StefansCode/BachelorThesisCS/README.md

This is my bachelor thesis in computer science.
