StefansCode/BachelorThesisCS/latex/tex/1_0_hardware.tex

\section{Die Hardware}

Das Ziel bei der Hardwarewahl ist es möglichst günstige und weit
verbreitete Komponenten zu wählen. So kann der Synthesizer
leicht nachgebaut werden.

\subsection{ESP32-S3}

\begin{figure}[h]
    \begin{center}
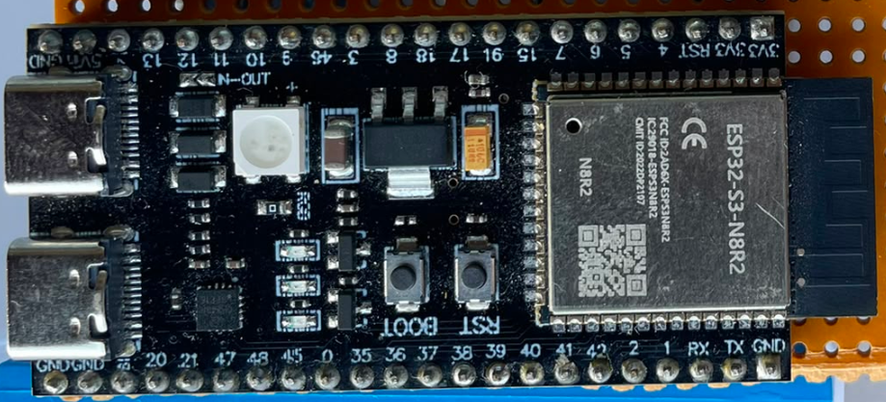
[picture p1: latex/fig/components/ESP32S3.png]
        
        \caption{ESP32-S3 Entwicklungsboard.}%
        \label{fig:ESP32S3}
    \end{center}
\end{figure}

% Neben Arduino-boards \cite{arduino} sind ESP32-boards von Espressif Systems
% \cite{espressif} die bekanntesten
% Mikrocontrollerboards. Außerdem sind sie für unter 10 € günstig erhältlich.

Die zentrale Recheneinheit des Synthesizers ist ein ESP-S3 von 
Espressif Systems.
Ein ESP32-S3 ist ein Mikrocontroller mit einer 
32-Bit-Dual-Core-CPU, die mit 240MHz betrieben werden kann\cite[4.1.1.1]{espDatashet}.
Bei einer Abtastrate von 44100 lässt sich theoretisch jeder Wert 
mit ca. 
$240MHz / 44100Hz = 5442$ Taktzyklen bearbeiten. Das lässt genug Zeit für 
verschiedene DSV-Operationen.

% Der ESP32-S3 wurde anderen ESP32 Microcontrollern vorgezogen, da er
% spezielle Hardware besitzt, um DSP-Operationen zu beschleunigen. Zum 
% Beispiel hat er spezielle Instruktionen für 128-Bit-Operationen
% \cite[4.1.1.2]{espDatashet}.

Ein weiterer Vorteil des ESP32-S3 ist, dass er viele GPIO-Pins und 
Peripherieschnittstellen hat.
Wichtig für dieses
Projekt sind vor allem GPIO-Pins für Taster und einen Encoder, I2C für 
einen OLED-Bildschirm und I2S für die Ausgabe der Audio-Signale.

\subsection{MAX98357A-I2S-DAC}

\begin{figure}[h]
    \begin{subfigure}{0.48\textwidth}
    \begin{center}
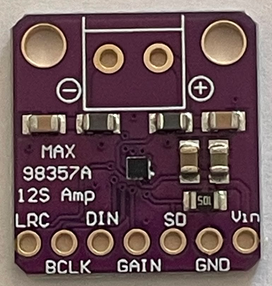
[picture p2: latex/fig/components/dac_front.png]
        
    \end{center}
    \end{subfigure}
    \hfill
    \begin{subfigure}{0.48\textwidth}
    \begin{center}
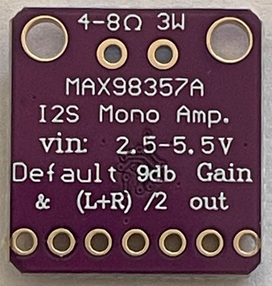
[picture p3: latex/fig/components/dac_back.png]
        
    \end{center}
    \end{subfigure}
\caption{MAX98357A-I2S-DAC}
\label{fig:DAC}
\end{figure}

Ein MAX98357A-DAC (Digital-zu-Analog Converter) \cite{MAX983572026Datasheet} 
ist ein Verstärker, der einen Digital-zu-Analog Converter (DAC) enthält.
Dieser wandelt das digitale Signal in analoges Signal um und verstärkt es so, dass es
direkt an einen passenden Lautsprecher weitergeleitet werden kann.
Dadurch kann während der Entwicklung auf einen externen Verstärker verzichtet werden.

Der MAX98357A kann Abtastraten von 8kHz, 16kHz, 32kHz, 44.1kHz,
48kHz, 88.2kHz oder 96kHz und eine Auflösung von 
16, 24 oder 32 Bit
verarbeiten \cite{MAX983572026Datasheet}[Digital Audio Interface Modes].

Das analoge Signal wird von dem DAC zu einer 3,5mm-Klinkenbuchse geleitet. 
So kann leicht ein Lautsprecher angeschlossen werden. 
% Klinkenstecher sind 
% unterteilt in mehrere segmente und haben in der Regel die Masseverbindung 
% an dem ring, der am nächsten am kabel ist. Deshalb wird der vorderste Pin 
% der Buchse mit dem negativen Ausgang des DACs verbunden. Da der MAX98357A 
% ein Monosignal (nur ein Signal und nicht rechts und links) sendet, werden 
% die beiden anderen Pins der Buchse mit dem Positiven Ausgang verbunden.

\begin{figure}[h]
    \begin{subfigure}{0.48\textwidth}
    \begin{center}
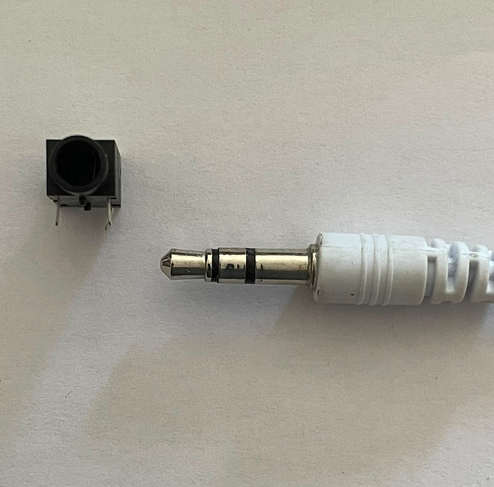
[picture p4: latex/fig/components/aux_front.png]
        
    \end{center}
    \end{subfigure}
    \hfill
    \begin{subfigure}{0.48\textwidth}
    \begin{center}
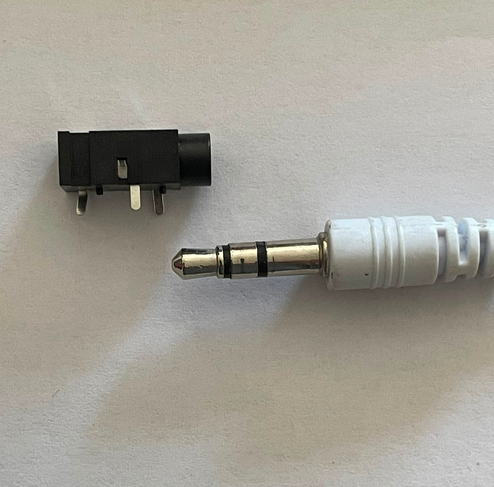
[picture p5: latex/fig/components/aux_side.png]
        
    \end{center}
    \end{subfigure}
\caption{Klinkenbuchse und Stecker}
\label{fig:AUX}
\end{figure}

\subsection{Nutzereingabe}

Als Nutzereingabe werden Taster und ein Drehgeber verwendet.

\begin{figure}[h]
    \begin{subfigure}{0.48\textwidth}
    \begin{center}
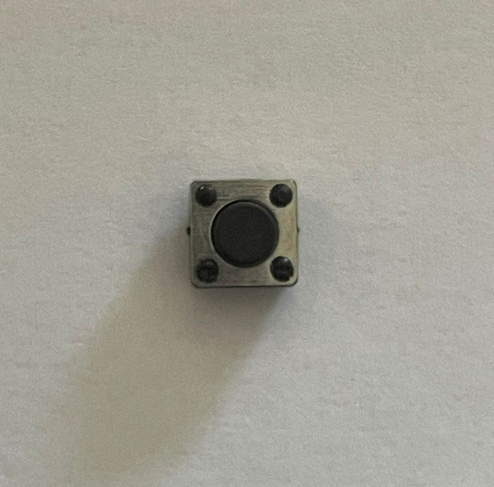
[picture p6: latex/fig/components/button_top.png]
        
    \end{center}
    \end{subfigure}
    \hfill
    \begin{subfigure}{0.48\textwidth}
    \begin{center}
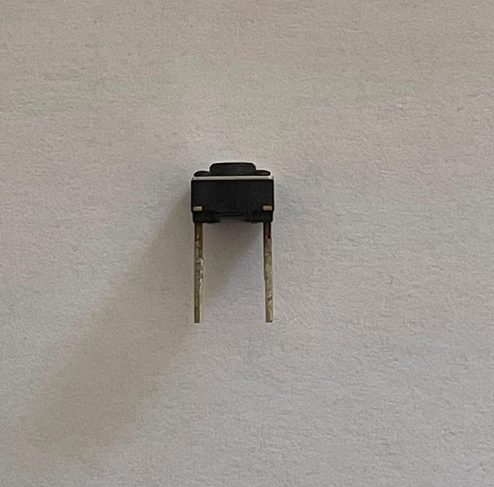
[picture p7: latex/fig/components/button_side.png]
        
    \end{center}
    \end{subfigure}
\caption{Einfacher Taster}
\label{fig:Taster}
\end{figure}

Ein Taster kann als einfacher Eingabeknopf genutzt werden. Er wird zwischen die Masse
und einen GPIO-Pin geschaltet und setzt diesen Pin beim Drücken auf LOW.

\begin{figure}[h]
    \begin{subfigure}{0.48\textwidth}
    \begin{center}
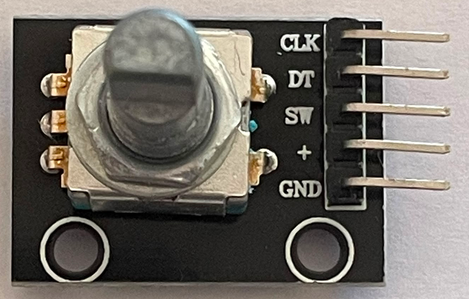
[picture p8: latex/fig/components/encoder_top.png]
        
    \end{center}
    \end{subfigure}
    \hfill
    \begin{subfigure}{0.48\textwidth}
    \begin{center}
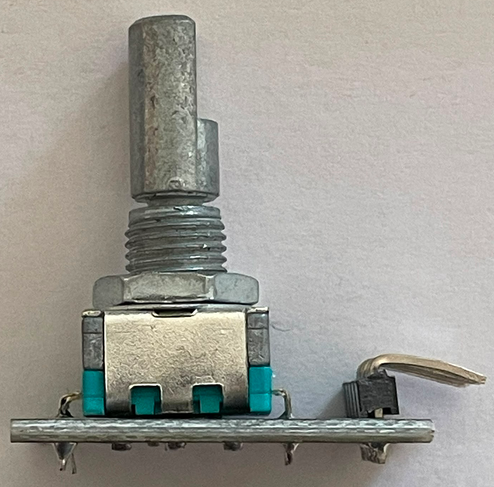
[picture p9: latex/fig/components/encoder_side.png]
        
    \end{center}
    \end{subfigure}
\caption{Drehgeber}
\label{fig:Drehgeber}
\end{figure}

Ein inkrementeller Drehgeber (englisch: encoder) kann mithilfe von zwei phasenverschobenen Signalen, die
an den Pins DT und CLK anliegen, angeben, in welche
Richtung er gedreht wird \cite{tiSBOA200}. Diese Drehung ist unbegrenzt, erfolgt aber
nur in Schritten. Die Pins müssen mit GPIO-Pins des ESP32-S3 
verbunden werden.

Mit 10 Tastern und einem Drehgeber ist es möglich,
während der Laufzeit verschiedene Variablen zu bearbeiten.
Die genaue Funktion dieser Komponenten wird in Kapitel \ref{chap:synth} beschrieben.

\subsection{OLED-Bildschirm}

\begin{figure}[h]
    \begin{subfigure}{0.48\textwidth}
    \begin{center}
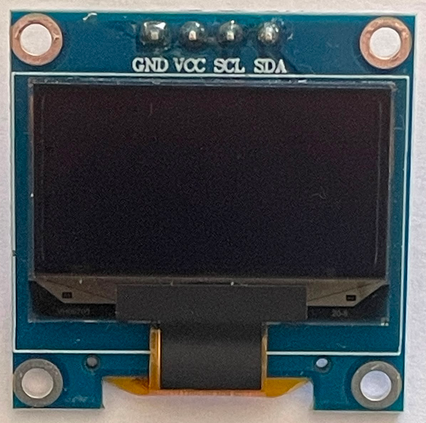
[picture p10: latex/fig/components/screen_front.png]
        
    \end{center}
    \end{subfigure}
    \hfill
    \begin{subfigure}{0.48\textwidth}
    \begin{center}
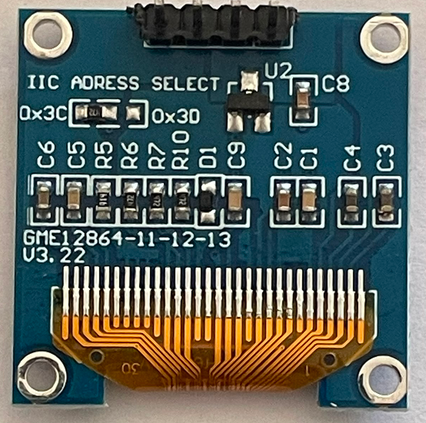
[picture p11: latex/fig/components/screen_back.png]
        
    \end{center}
    \end{subfigure}
\caption{OLED-Bildschirm}
\label{fig:OLED-Bildschirm}
\end{figure}

Ein SSD1306 OLED-Bildschirm mit einer Auflösung von 128x64 Pixeln wird genutzt, 
um dem Nutzer anzuzeigen, welche
Variable geändert wird. Die Verbindung zum ESP32 passiert über das
I2C-Protokoll.

\subsection{Pinbelegung und Löten}

Nun müssen alle Komponenten mit dem ESP32-S3 verbunden werden.
Der ESP32-S3 hat intern eine GPIO-Matrix, welche es ermöglicht fast
jeden internen Peripheriecontroller mit fast jedem Pin zu verbinden 
\cite{esp32S3gpio}.

Zusätzlich zu den oben aufgezählten Komponenten wurden ein SD-Karten-Anschluss
über die SPI-Schnittstelle als mögliche Erweiterung verbunden. 
Dieser wurde in dieser Arbeit allerdings nicht genutzt.

Die Wahl der Pins ist für I2S, I2C und GPIO fast immer frei wählbar.
Es ist zwar möglich die folgenden Ausnahmen zu benutzen, aber nicht empfohlen.
\begin{itemize}
    \item Pins 19 und 20 sind mit dem JTAG-Debugger verbunden.
    \item Pins 44 und 48 sind mit den eingebauten LEDs verbunden.
    \item Pins 0, 3, 45 und 46 sind Strappingpins. Das sind Pins, die das Bootverhalten
            ändern können, je nachdem, ob an ihnen während des Bootvorgangs ein
            High- oder Low-Pegel anliegt.
    \item Pins 33--37 sind mit dem SPI-Flash und dem PSRAM auf dem
    Entwicklungsboard verbunden.
\end{itemize}

Mit diesen Einschränkungen wurde die Pinbelegung aus Anhang \ref{sec:pinout} 
gewählt.
Anschließend wurde alles auf eine Lochplatine gelötet. 
Diese ist in Abbildung \ref{fig:platine} zu sehen.

\subsection{Design und Drucken eines Gehäuses}

Als Abschluss der Hardware wurde das Gehäuse aus Abbildung \ref{fig:hülle_außen} 
3D-gedruckt. Dieses
ist natürlich hauptsächlich für die Optik, es sorgt aber auch für ein 
besseres Handgefühl und schützt die Platine vor Beschädigungen.

Zum Erstellen des 3D-Objektes wurde Fusion360\cite{fusion360} verwendet.
In Fusion360 ist es möglich ein Bild als Referenz zu laden. 
Das hat sich als schneller und genauer herausgestellt, als die Maße von der 
Platine zu nehmen.

% In Fusion360 wird das erstellte 3D-Objekt als stl-Datei exportiert und dann
% in dem Bambu Lab Studio Slicer \cite{bambulabStudio} zu einer gcode-Datei konvertiert.
% Eine gcode-Datei enthält die Anweisungen für den 3D-Drucker und in einem 
% Slicer kann man Parameter wie die Schichthöhe, die Druckgeschwindigkeit, 
% die Temperatur der Düse und der Heizplatte, die Fülldichte von 
% Holräumen, etc. einstellen. Außerdem werden Stützen für Überhänge erstellt,
% da der Drucker nicht in der Luft drucken kann und man kann sehen wieviel 
% Material verbraucht wird und wie lange der Druck braucht.
% Der gcode wird dann an den 3D-Drucker Bambu Lab P1S \cite{bambulabP1S}
% geschickt, der das Gehäuse Schicht für Schicht druckt.

% Zunächst wurde ein dünner Prototyp der Vorderseite gedruckt, da diese die 
% meisten Öffnungen hat. Nach ein paar kleinen Anpassungen wurden die 
% Seitenwände mit einer kleinen Einkerbung am Ende erstellt. Nach Maßen
% wurden Löcher für die USB-, Aux- und SD-Karten-Anschlüsse hinzugefügt.

% Es wurden 10 Knöpfe für die Taster gedruckt. Die Aufschriften der Knöpfe sind 
% A, B, 1, 2, 3, 4, 5, 6, 7 und 8. Deren Funktionen werden in Kapitel \ref{chap:synth} beschrieben.

% In die Löcher für die Taster kommen kleine Knöpfe, die genau in die 
% Löcher passen, aber unten etwas breiter sind damit sie nicht hinausfallen.
% Für den Boot- und Resetknopf auf dem ESP32-S3 gibt es Auch jeweils einen Knopf.
% Die sind allerdings kleiner. 

% Die Platine wird durch 2 Säulen und 4 kleine Blöcke in dem Gehäuse gehalten. 
% In die Spitze der Säulen wurden Einschmelzgewinde eingeschmolzen, 
% um die Rückwand des Gehäuses mit Schrauben zu befestigen.

Zum Drucken wurde der 3D-Drucker Bambu Lab P1S \cite{bambulabP1S} verwendet.
Auf der Githubseite zu dieser Arbeit sind die STL-Datei und eine STEP-Datei
des Gehäuses zu finden\cite{meinGithub}.
