StefansCode/BachelorThesisCS/latex/appendix.tex

\section{Pinbelegung}
\label{sec:pinout}
\begin{table}[H]
    \centering
    \begin{tabular}{c|l|l|l}
        \textbf{Pin} & \textbf{Typ} & \textbf{Funktion} & \textbf{Bemerkung} \\
        \hline
        0  & --        & --              & Strapping-Pin, nicht empfohlen \\
        1  & PCNT      & Encoder DT      & \\
        2  & PCNT      & Encoder CLK     & \\
        3  & --        & --              & Strapping-Pin, nicht empfohlen \\
        4  & GPIO IN   & BTN\_11         & \\
        5  & GPIO IN   & BTN\_12         & \\
        6  & GPIO IN   & BTN\_13         & \\
        7  & GPIO IN   & BTN\_14         & \\
        8  & GPIO IN   & Encoder\_SW     & \\
        9  & GPIO IN   & BTN\_21         & \\
        10 & GPIO IN   & BTN\_22         & \\
        11 & GPIO IN   & BTN\_23         & \\
        12 & GPIO IN   & BTN\_24         & \\
        13 & GPIO IN   & BTN\_B          & \\
        14 & GPIO IN   & BTN\_A          & \\
        15 & --        & --              & \\
        16 & I\textsuperscript{2}S & I\textsuperscript{2}S DIN & DAC \\
        17 & I\textsuperscript{2}S & I\textsuperscript{2}S BCK & DAC \\
        18 & I\textsuperscript{2}S & I\textsuperscript{2}S LRC & DAC \\
        19 & USB-JTAG  & USB-JTAG        & standardmäßig USB D- \\
        20 & USB-JTAG  & USB-JTAG        & standardmäßig USB D+ \\
        21 & --        & --              & \\
        \hline
        22--34 & --     & nicht vorhanden & \\
        \hline
        35--37 & --     & Flash/PSRAM     & abhängig von Flash/PSRAM-Konfiguration \\
        38 & SPI       & SPI CS          & SD-Karte \\
        39 & SPI       & SPI MOSI        & SD-Karte\\
        40 & SPI       & SPI CLK         & SD-Karte\\
        41 & SPI       & SPI MISO        & SD-Karte\\
        42 & I\textsuperscript{2}C & I\textsuperscript{2}C SCL\\
        43 & --        & --              & U0TXD / UART0 \\
        44 & GPIO      & BUILTIN\_LED    & U0RXD / UART0 \\
        45 & --        & --              & Strapping-Pin, nicht empfohlen \\
        46 & --        & --              & Strapping-Pin, nicht empfohlen \\
        47 & I\textsuperscript{2}C & I\textsuperscript{2}C SDA & \\
        48 & RMT       & BUILTIN\_RGB\_LED & Fehleranzeige \\
    \end{tabular}
    \caption{Pinbelegung des ESP32-S3.}
    \label{tab:pinout}
\end{table}

\section{Bilder zur Entwicklung der Hülle}

\begin{figure}[h]
    \begin{subfigure}{0.48\textwidth}
    \begin{center}
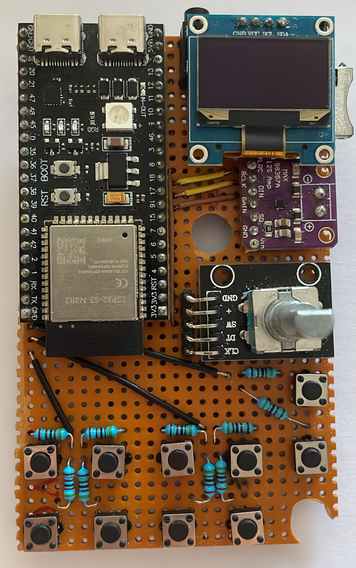
[picture p12: latex/fig/case/platine_front.png]
        
    \end{center}
    \end{subfigure}
    \hfill
    \begin{subfigure}{0.48\textwidth}
    \begin{center}
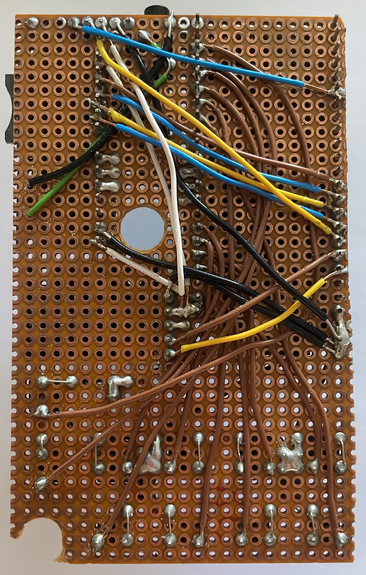
[picture p13: latex/fig/case/platine_back.png]
        
    \end{center}
    \end{subfigure}
\caption{Lochplatine mit angelöteten Komponenten}
\label{fig:platine}
\end{figure}

\begin{figure}[H]
    \begin{subfigure}{0.48\textwidth}
    \begin{center}
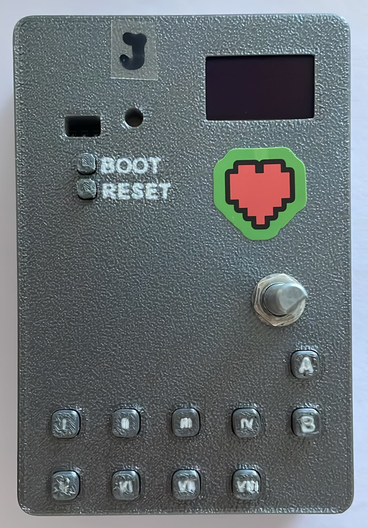
[picture p14: latex/fig/case/assembled_front.png]
        
    \end{center}
    \end{subfigure}
    \hfill
    \begin{subfigure}{0.48\textwidth}
    \begin{center}
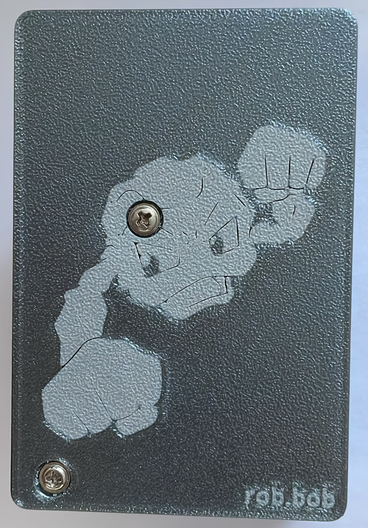
[picture p15: latex/fig/case/assembled_back.png]
        
    \end{center}
    \end{subfigure}
\caption{Ein Gehäuse für die Platine}
\label{fig:hülle_außen}
\end{figure}

\begin{figure}[H]
    \begin{subfigure}{0.48\textwidth}
    \begin{center}
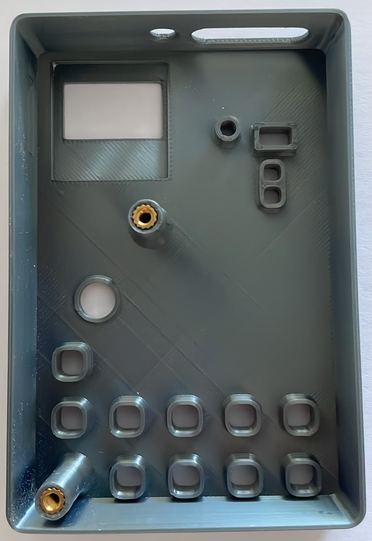
[picture p16: latex/fig/case/front_case_inside.png]
        
    \end{center}
    \end{subfigure}
    \hfill
    \begin{subfigure}{0.48\textwidth}
    \begin{center}
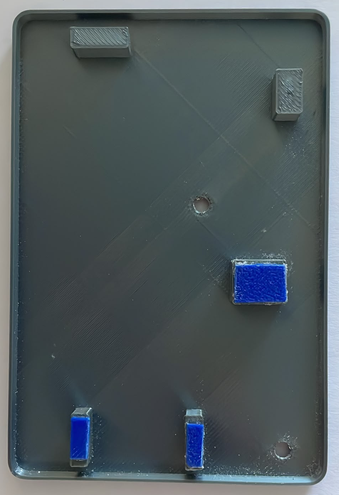
[picture p17: latex/fig/case/back_case_inside.png]
        
    \end{center}
    \end{subfigure}
\caption{Innenseite der Hülle}
\label{fig:hülle_innen}
\end{figure}

\begin{figure}[H]
    \begin{center}
        
    \end{center}
    \caption{Knöpfe von der Seite}
    \label{fig:knöpfe}
\end{figure}

\begin{figure}[H]
    \begin{center}
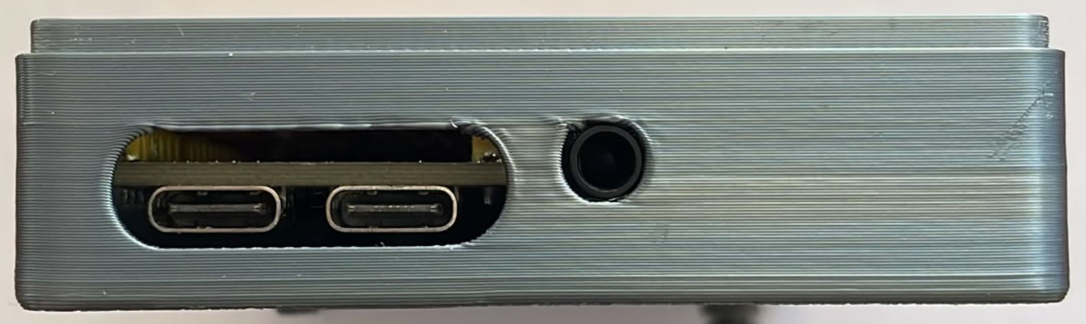
[picture p18: latex/fig/case/case_top.png]
        
    \end{center}
    \caption{Oberseite und Vorderseite der Hülle}
    \label{fig:hülle_oben}
\end{figure}

\begin{figure}[H]
    \begin{center}
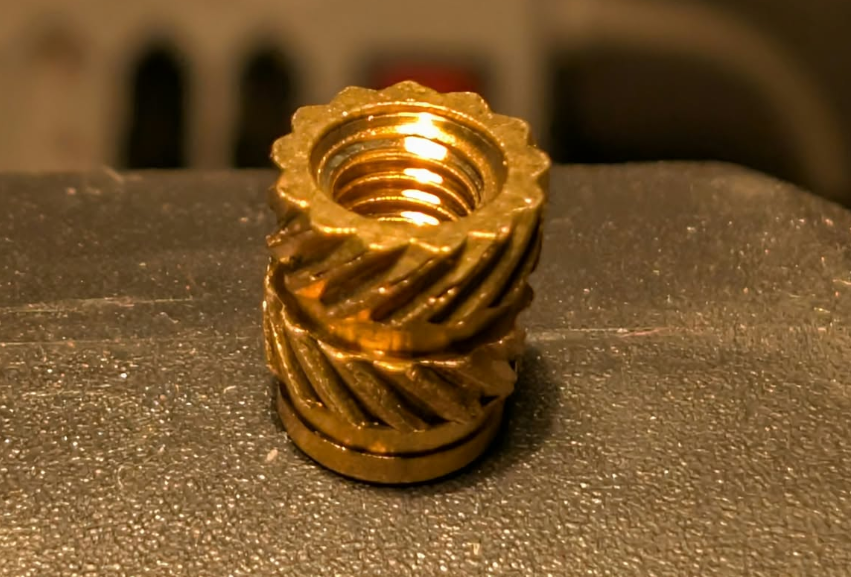
[picture p19: latex/fig/case/Einschmelzgewinde.png]
        
        \caption{Einschmelzgewinde.}%
        \label{fig:einschmelzgewinde}
    \end{center}
\end{figure}

\begin{figure}[h]
    \begin{center}
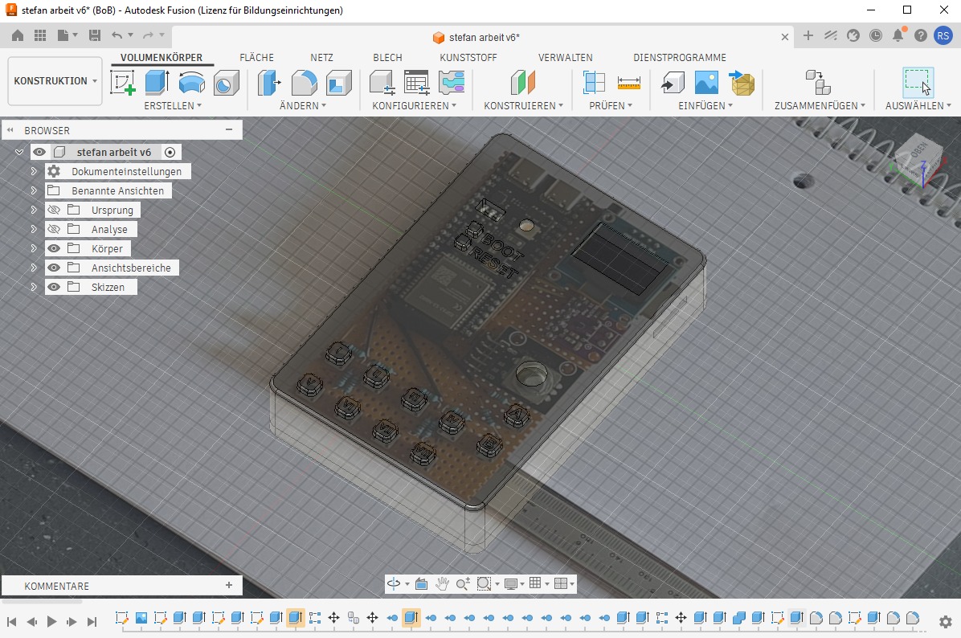
[picture p20: latex/fig/case/hülle_in_fusion.jpeg]
        
        \caption{Fusion360 mit dem Gehäuse und dem geladenem Bild der Platine.}%
        \label{fig:fusion360}
    \end{center}
\end{figure}

\begin{figure}[H]
    \begin{center}
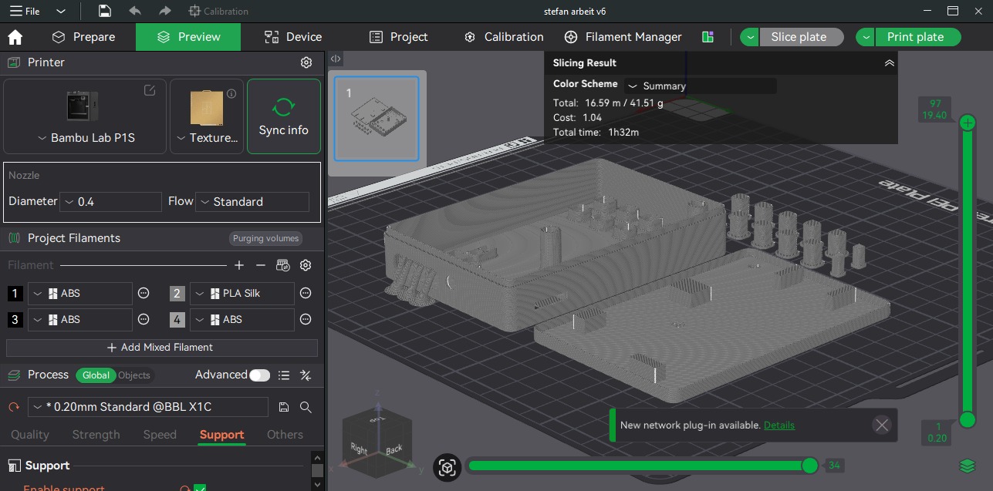
[picture p21: latex/fig/case/hülle_im_slicer.jpeg]
        
        \caption{Slicer mit der Hülle.}%
        \label{fig:slicer}
    \end{center}
    
\end{figure}

\begin{figure}[H]
    \begin{center}
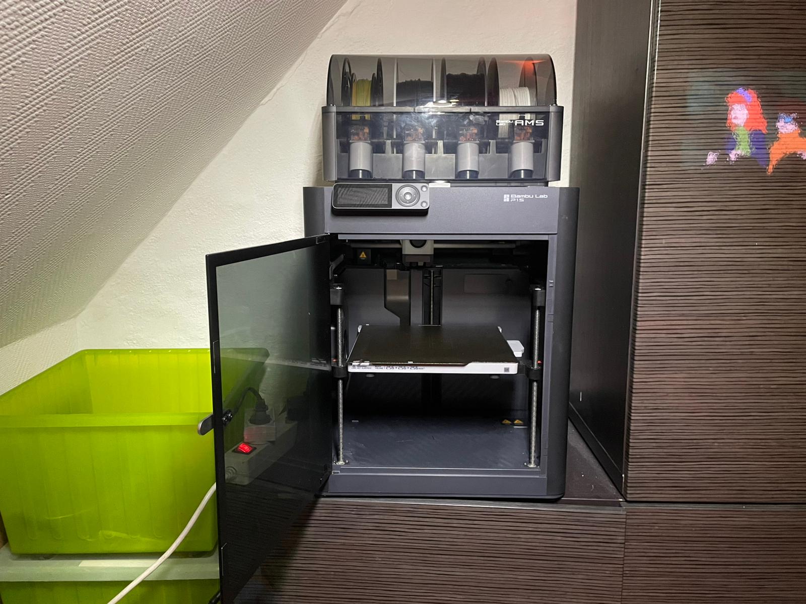
[picture p22: latex/fig/case/3D_Drucker.jpeg]
        
        \caption{Der 3D-Drucker Bambu Lab P1S}%
        \label{fig:drucker}
    \end{center}
    
\end{figure}

\section{Beispielcode für die DSV-Bibliothek}
\label{example:DSV}

\begin{lstlisting}[language=C++, 
                   frame=single, 
                   caption={Beispielcode für die DSV-Bibliothek in der Arduino IDE},
                   captionpos=b]
#include "signal.h"

Signal<int, 16> lightSignal;
Signal<int, 16> potiSignal;

void setup() {
  pinMode(2, OUTPUT);
  Serial.begin(9600);
}

void loop() {

  potiSignal.fromValue(analogRead(A7))
            .applyFunction(printSignal, "poti")
            .multiply(-1);
  
  lightSignal.fromValue(analogRead(A6))
             .applyFunction(printSignal, "lightLevel")
             .add(potiSignal)
             .applyFunction(printSignal, "calibrated")
             .applyFunction(switchLight, NULL);

  Serial.println();
  delay(1);
}

int printSignal(int sample, const void * param) {
  const char * variableName = (const char*) param;
  
  Serial.print(variableName);
  Serial.print(":");
  Serial.print(sample);
  Serial.print(" ");

  return sample;
}

int switchLight(int sample, void * param) {
    if(sample < 0) {
    digitalWrite(2,HIGH);
  } else {
    digitalWrite(2,LOW);
  }
  return sample;
}
\end{lstlisting}

\section{Code des einfachen Synthesizers}
\label{sec:simple_synth_code}

\begin{lstlisting}[language=C++, 
                   frame=single, 
                   caption={Code des einfachen Synthesizers},
                   captionpos=b]

#ifndef MINI_SYNTH_H
#define MINI_SYNTH_H
#include "adapter/button/button.h"
#include "adapter/dac/i2sDac.h"
#include "sound/sound.h"

Sound bass;

Sound sound1;
Sound sound2;
Sound sound3;
Sound sound4;
Sound sound5;
Sound sound6;
Sound sound7;
Sound sound8;

// Array, um ueber einen Index auf die einzelnen Sounds zuzugreifen
Sound leads[8] = 
{sound1, sound2, sound3, sound4,
 sound5, sound6, sound7, sound8};
unsigned int note[8] = 
{440, 494, 554, 587, 
 659, 740, 831, 880};
int buttonsPin[8] = 
{PIN_BTN_11, PIN_BTN_12, PIN_BTN_13, PIN_BTN_14, 
 PIN_BTN_21, PIN_BTN_22, PIN_BTN_23, PIN_BTN_24};

void runMiniSynthTest() {

  float playBass = 0;

  while (1) {
    if (buttons.readQueue() == PIN_BTN_B) {
      if (playBass == 0) {
        playBass = 1;
      } else {
        playBass = 0;
      }
    }
    for (int j = 0; j < SOUND_BUFFER_SIZE; j++) {
      // generiere den Bass
      bass.fromSaw(110)       
          // mache den Bass leiser
          .amplify(0.1f)      
          // mache den Bass aus wenn playBass == 0
          .amplify(playBass); 
      for (int i = 0; i < 8; i++) {
        float b = (float)buttons.getState(buttonsPin[i]);
        // Die Toene der einzelnen Tasten
        // werden wie der Bass generiert.
        leads[i].fromSaw(note[i])  
                .amplify(0.1f)     
                .amplify(b);
        // Addiere die Toene der einzelnen Tasten zum Bass
        bass.add(leads[i]);   
      }
      // Mache nun alles leiser
      bass.amplify(0.3f);     
    }
    // Wenn der Buffer voll ist, sende ihn an den DAC
    dac.sendBuffer(bass.returnBuffer(),
                   SOUND_BUFFER_SIZE * sizeof(sample));
  }
}

#endif // MINI_SYNTH_H
    
\end{lstlisting}
