StefansCode/BachelorThesisCS/latex/tex/6_LessensLearned_und_Zukunft.tex

\section{Lessons Learned und zukünftige Erweiterungen}

\subsection{Hardware}

Folgende Hardwareerweiterungen sind denkbar, um die Funktionalität des Synthesizers zu erweitern.

\begin{itemize}
    \item Als mögliche Hardwareerweiterungen wäre ein Analog-Digital-Wandler (ADC) 
        interessant um die Eingabe von Audiosignalen zu ermöglichen.
    \item Die Audoiausgabe über einen DAC ohne Verstärker ist auch möglich, und 
        erlaubt das Abspielen der Töne über externe Verstärker.
    \item Eine speziell angefertigte Platine würde das Löten und 
        die Entwicklung des Gehäuses vereinfachen.
\end{itemize}

\subsection{Software}

Um die Ausführungsgeschwindigkeit der Sound Methoden zu bewerten, 
werden die Multiplikation von einem Soundobjekt mit einer Variable und 
die Multiplikation eines Arrays mit einer Variable verglichen. Dabei braucht das
Soundobjekt wie oben gesehen 1,17 \%, aber die Arraymultiplikation nur 0,84 \%.
Addieren hat einen ähnlichen Overhead.

Einige Ideen zum Verbessern dieser Zeiten sind im Folgenden aufgelistet.
\begin{enumerate}
    \item Die Berechnung der Sägezahnwelle kann, laut Grüningen
    \cite[7.1.1]{grueningen2008dsv}, schneller implementiert werden.
    \item Da dem DAC immer ein Buffer übergeben wird, können Operationen auf dem ganzen
    Buffer durchgeführt werden. Dadurch kann Gebrauch von der Hardwarebeschleunigung
    gemacht werden. Mit Buffern zu arbeiten ist ein typisches Verfahren in der DSV.
    Zum Beispiel nehmen Funktionen der ESP-DSV-Bibliothek \cite{ESPDSV} ganze Buffer an.
    \item Nutze die ESP-DSV-Bibliothek. Wenn mit dem ganzen Buffer gearbeitet wird, 
    dann sollte die ESP-DSV-Bibliothek genutzt werden, da diese für die Hardware des 
    ESP32 und teilweise auch auf die Hardware des ESP32-S3 optimiert wurde.
\end{enumerate}

Für die weitere Entwicklung sollten außerdem automatisierte Unit-Tests für
Signaloperationen geschrieben werden, dies ist möglich da die SignalKlasse
unabhängig von der verwendeten Hardware ist.

Es ist auch möglich weitere Funktionen in der Signalbibliothek und der 
Audiobiliothek zu implementieren. Dazu empfiehlt es sich das Buch
von Grüningen \cite{grueningen2008dsv} zu lesen, um über digitale Filter zu 
lernen und das Buch von Zölzer \cite{DAFX} zu lesen, um über digitale Audioeffekte zu 
lernen.
