StefansCode/BachelorThesisCS/latex/tex/3_Digitale_Audio.tex

\section{Entwicklung einer Darstellung eines digitalen Tons}
\label{chap:digitale_ton_darstellung}

Wie oben erwähnt kann ein Ton als Signal dargestellt werden. Dazu
werden zunächst als Auflösung 16Bit, also ein \lstinline|int16_t|,
und als Abtastrate 32786Hz gewählt. Außerdem wurde die Bufferlänge auf 256 gesetzt. 
Diese 3 Werte werden in einer Header-Datei namens config.h gespeichert. Sie
gehört zu der Sound-Komponente.

\begin{lstlisting}[language=C++, 
                       frame=single, 
                       caption={Standardparameter eines Soundobjekts},
                       captionpos=b]
#define STANDARD_SAMPLE_RATE 32768
typedef int16_t sample;
#define SOUND_BUFFER_SIZE 256
\end{lstlisting}

In der Soundklasse, gibt es ein Signalobjekt, welchem der Sampletyp
und die Auflösung übergeben wurden. Die Abtastrate und Auflösung werden
dem DAC übergeben.

Wie in Kapitel \ref{chap:signalbibliothek} erwähnt, hängt die Abtastrate davon ab,
wie oft pro Sekunde eine Inputfunktion aufgerufen wird.

\subsection{Generierung von Audiosignalen}
Anders als in der Signalklasse generieren hier die Inputfunktionen 
eigene Werte. Den Inputfunktionen wird eine Frequenz übergeben, und es
soll eine periodische Funktion mit dieser Frequenz und einer bestimmten
Form generiert werden. Wie Grüningen \cite[7.1]{grueningen2008dsv} 
erwähnt sind Sägezahn-, Rechteck und Dreieckgeneratoren leicht zu 
implementieren. Da die Sinuswelle eine fundamentale Rolle für Signale
jeder Art spielt, soll auch diese implementiert werden.

\begin{figure}[h]
    \centering

    \begin{tikzpicture}

        % Sine
        \begin{axis}[
            width=7cm,
            height=4.5cm,
            title={Sinus},
            xlabel={Zeit},
            ylabel={Wert},
            xmin=0, xmax=2*pi,
            ymin=-1.2, ymax=1.2,
            xtick={0,2*pi},
            xticklabels={$0$,$1$},
            ytick={-1,0,1},
            grid=major,
        ]
            \addplot[
                color=red,
                line width=1.5pt,
                domain=0:2*pi,
                samples=200
            ] {sin(deg(x))};
        \end{axis}

        % Sawtooth
        \begin{axis}[
            width=7cm,
            height=4.5cm,
            title={Sägezahn},
            xlabel={Zeit},
            ylabel={Wert},
            xmin=0, xmax=2*pi,
            ymin=-1.2, ymax=1.2,
            xtick={0,2*pi},
            xticklabels={$0$,$1$},
            ytick={-1,0,1},
            grid=major,
            at={(7.5cm,0)},
        ]
            \addplot[
                color=red,
                line width=1.5pt,
                domain=0:2*pi,
                samples=200
            ] {2*(x/(2*pi)-floor(x/(2*pi)+0.5))};
        \end{axis}

        % Square
        \begin{axis}[
            width=7cm,
            height=4.5cm,
            title={Rechteck},
            xlabel={Zeit},
            ylabel={Wert},
            xmin=0, xmax=2*pi,
            ymin=-1.2, ymax=1.2,
            xtick={0,2*pi},
            xticklabels={$0$,$1$},
            ytick={-1,0,1},
            grid=major,
            at={(0,-5.5cm)},
        ]
            \addplot[
                color=red,
                line width=1.5pt,
                domain=0:2*pi,
                samples=200
            ] {sign(sin(deg(x)))};
        \end{axis}

        % Triangle
        \begin{axis}[
            width=7cm,
            height=4.5cm,
            title={Dreieck},
            xlabel={Zeit},
            ylabel={Wert},
            xmin=0, xmax=2*pi,
            ymin=-1.2, ymax=1.2,
            xtick={0,2*pi},
            xticklabels={$0$,$1$},
            ytick={-1,0,1},
            grid=major,
            at={(7.5cm,-5.5cm)},
        ]
            \addplot[
                color=red,
                line width=1.5pt,
                domain=0:2*pi,
                samples=200
            ] {2*abs(2*(x/(2*pi)-floor(x/(2*pi)+0.5)))-1};
        \end{axis}

    \end{tikzpicture}

    \caption{Typische Wellenformen der digitalen Klangsynthese.}
    \label{fig:waveforms}

\end{figure}

Wegen ihrer Einfachheit sind diese 4 Signale typische Formen in der 
Klangsynthese \cite[3.3]{computerMusic}.

Es gibt also vier Inputfunktionen. Diese nehmen als Parameter eine Frequenz
und greifen auf einen MemberVariable namens \lstinline|time| zu. 
\lstinline|time| wird bei jedem
Aufruf einer Inputfunktion um Eins erhöht und ist der X-Wert der 
zu generierten Funktionen. Da nur ganzzahlige Frequenzen größer oder gleich null
betrachtet werden sollen, ist jede mögliche Frequenz ein Vielfaches
von Eins und somit ist auch jede generierte Funktion 1-periodisch (sie wiederholt
sich bei eins). 

\begin{figure}[h]
    \centering

    \begin{tikzpicture}

        % Sine
        \begin{axis}[
            width=7cm,
            height=4.5cm,
            title={1Hz},
            xlabel={Zeit},
            ylabel={Wert},
            xmin=0, xmax=1,
            ymin=-1.2, ymax=1.2,
            xtick={0,1},
            ytick={-1,0,1},
            grid=major,
        ]
            \addplot[
                color=red,
                line width=1.5pt,
                domain=0:1,
                samples=200
            ] {sin(deg(x)*2*pi)};
        \end{axis}

        % Sawtooth
        \begin{axis}[
            width=7cm,
            height=4.5cm,
            title={3Hz},
            xlabel={Zeit},
            ylabel={Wert},
            xmin=0, xmax=1,
            ymin=-1.2, ymax=1.2,
            xtick={0,1},
            ytick={-1,0,1},
            grid=major,
            at={(7.5cm,0)},
        ]
            \addplot[
                color=red,
                line width=1.5pt,
                domain=0:1,
                samples=200
            ] {sin(deg(x)*3*2*pi)};
        \end{axis}

        % Square
        \begin{axis}[
            width=7cm,
            height=4.5cm,
            title={7Hz},
            xlabel={Zeit},
            ylabel={Wert},
            xmin=0, xmax=1,
            ymin=-1.2, ymax=1.2,
            xtick={0,1},
            ytick={-1,0,1},
            grid=major,
            at={(0,-5.5cm)},
        ]
            \addplot[
                color=red,
                line width=1.5pt,
                domain=0:1,
                samples=200
            ] {sin(deg(x)*7*2*pi)};
        \end{axis}

        % Triangle
        \begin{axis}[
            width=7cm,
            height=4.5cm,
            title={10Hz},
            xlabel={Zeit},
            ylabel={Wert},
            xmin=0, xmax=1,
            ymin=-1.2, ymax=1.2,
            xtick={0,1},
            ytick={-1,0,1},
            grid=major,
            at={(7.5cm,-5.5cm)},
        ]
            \addplot[
                color=red,
                line width=1.5pt,
                domain=0:1,
                samples=200
            ] {sin(deg(x)*10*2*pi)};
        \end{axis}

    \end{tikzpicture}

    \caption{Eine Sinuskurve mit verschiedenen Frequenzen.}
    \label{fig:waveforms_with_different_frequenzys}

\end{figure}

Für die digitale Darstellung heißt das, wenn $s$ (samplerate) die Abtastrate ist
kann time alle $s$ Aufrufe zurückgesetztwerden. 
Zu Begin jeder Inputfunktion wird also 
\begin{lstlisting}
    time = (time + 1) % STANDARD_SAMPLE_RATE; 
\end{lstlisting}
aufgerufen.

\subsubsection{Generierung einer Sägezahnwelle}

Seien im Folgenden $s$ die Abtastrate, $a$ die Auflösung und $f$ 
die Frequenz. Außerdem wird für time $x$ geschrieben und für den 
berechnete Wert $y$.
Um eine Sägezahnwelle zu generieren, startet man mit der Identität
$y=x$
und passt diese mit den folgenden Schritten an.

\begin{enumerate}
    \item $y=x$ Die Identität wird als Ausgangspunkt genommen.
    \item $y=(-a/2)+(x*a/s)$ Die Funktion wird auf die Auflösung skaliert.
    \item $y=(-a/2)+((x*a/s) \bmod a)$ Die Funktion wird periodisch gemacht, indem mit der auflösung Modulo gerechnet wird.
    \item $y=(-a/2)+((x*f*a/s) \bmod a)$ Die Zeit $x$ wird mit der Frequenz $f$ multipliziert, um die gewünschte Frequenz zu erhalten.
\end{enumerate}

\begin{figure}[h]
    \centering

    \begin{tikzpicture}

        % Identität
        \begin{axis}[
            width=7cm,
            height=4.5cm,
            title={1. $y=x$},
            xlabel={Zeit},
            ylabel={Wert},
            xmin=-0.2, xmax=1.2,
            ymin=-0.2, ymax=1.2,
            xtick={0,1},
            xticklabels ={$0$, $s$},
            ytick={0,1},
            yticklabels ={$0$,$s$},
            grid=major,
        ]
            \addplot[
                color=red,
                line width=1.5pt,
                domain=-0.2:1.2,
                samples=200
            ] {x};
        \end{axis}

        % skaliert
        \begin{axis}[
            width=7cm,
            height=4.5cm,
            title={2. $y=-(a/2)+(x*a/s)$},
            xlabel={Zeit},
            ylabel={Wert},
            xmin=-0.2, xmax=1.2,
            ymin=-0.7, ymax=0.7,
            xtick={0,1},
            xticklabels ={$0$, $s$},
            ytick={-0.5, 0, 0.5},
            yticklabels ={$-a/2$, $0$, $a/2$},
            grid=major,
            at={(7.5cm,0)}
        ]
            \addplot[
                color=red,
                line width=1.5pt,
                domain=-0.2:1.2,
                samples=200
            ] {x-0.5};
        \end{axis}

        % periodisch
        \begin{axis}[
            width=7cm,
            height=4.5cm,
            title={3. $y=-(a/2)+((x*a/s) \bmod a)$},
            xlabel={Zeit},
            ylabel={Wert},
            xmin=-0.2, xmax=1.2,
            ymin=-0.7, ymax=0.7,
            xtick={0,1},
            xticklabels ={$0$, $s$},
            ytick={-0.5, 0, 0.5},
            yticklabels ={$-a/2$, $0$, $a/2$},
            grid=major,
            at={(0,-5.5cm)}
        ]
            \addplot[
                color=red,
                line width=1.5pt,
                domain=-0.2:1.2,
                samples=200
            ] {(x - floor(x))-0.5};
        \end{axis}

        % periodisch
        \begin{axis}[
            width=7cm,
            height=4.5cm,
            title={4. $y=-(a/2)+((x*f*a/s) \bmod a)$},
            xlabel={Zeit},
            ylabel={Wert},
            xmin=-0.2, xmax=1.2,
            ymin=-0.7, ymax=0.7,
            xtick={0,1},
            xticklabels ={$0$, $s$},
            ytick={-0.5, 0, 0.5},
            yticklabels ={$-a/2$, $0$, $a/2$},
            grid=major,
            at={(7.5cm,-5.5cm)}
        ]
            \addplot[
                color=red,
                line width=1.5pt,
                domain=-0.2:1.2,
                samples=200
            ] {(x*3 - floor(x*3))-0.5};
        \end{axis}

    \end{tikzpicture}

    \caption{Generierung einer Sägezahnwelle mit Frequenz 3 Hz.}
    \label{fig:saw_generation}

\end{figure}

Da die Sägezahnwelle auch für die Berechnung der anderen 
Wellenformen genutzt wird, ist es sinnvoll diese als eigene 
Funktion zu implementieren.

\begin{lstlisting}[language=C++, 
                       frame=single, 
                       caption={Generierung einer Sägezahnwelle im Code},
                       captionpos=b]
sample Sound::calculateSaw(unsigned int frequency) {
    int64_t phase = ((int64_t)(time) * frequency) 
                    % STANDARD_SAMPLE_RATE;
    int64_t value = (int64_t)(SAMPLE_MIN) 
                    +(phase * SAMPLE_RANGE) 
                    / STANDARD_SAMPLE_RATE;
    return (sample)(value);
}
\end{lstlisting}

Zur bBerrechnung der Sägezahnwelle werden int64\_t genutzt, um einen Overflow zu vermeiden.
SAMPLE\_MIN ist der kleinste Wert, den ein Sample annehmen kann und SAMPLE\_RANGE
ist die Differenz zwischen dem größten und dem kleinsten Wert, den ein Wert 
annehmen kann.

\subsubsection{Generierung einer Rechteckwelle}

Um eine Rechteckwelle $\text{rect}(t)$ zu generieren, wird die 
Sägezahnwelle $\text{saw}(t)$ wie folgt genutzt: 

\begin{equation}
    \text{rect}(t) = \begin{cases}
        -a/2, & \text{wenn } \text{saw}(t) < 0 \\
        a/2, & \text{sonst}
    \end{cases}
\end{equation}

\subsubsection{Generierung einer Dreieckswelle}

Auch für die Dreieckswelle $\text{tri}(t)$ wird die 
Sägezahnwelle $\text{saw}(t)$ genutzt:

\begin{equation}
    \text{tri}(t) = \begin{cases}
        (a/2) + (2*\text{saw}(t)), & \text{wenn } \text{saw}(t) < 0 \\
        (a/2) - (2*\text{saw}(t)), & \text{sonst}
    \end{cases}
\end{equation}

\subsubsection{Generierung einer Sinuswelle}

Da die Berechnung des Sinus viel aufwendiger ist 
als die Berechnung der anderen Wellenformen
(siehe \ref{chap:Bewertung_der_Auflösung_und_Abtastrate}),
werden diese Werte vorher berechnet und in einem Array gespeichert.
Während der Laufzeit wird der Index basierend auf der Frequenz und der
Zeit berechnet und der Wert aus dem Array gelesen.
Das Array ist $s$ lang und enthält die Werte für eine Periode der 
Sinuswelle.

\subsection{Addition und Multiplikation}
\label{chap:addition_and_multiplication}

Wenn man zwei Töne gleichzeitig hört, dann hört man diese als
einen neuen Ton, welche die Addition der beiden Töne ist \cite[16.5]{openStacksWaves}.

Die Addition von zwei Tönen ist in der Soundklasse als Funktion 
\lstinline{add(Sound * other)} implementiert. Diese ruft die 
add-Funktion der Signalklasse auf. 

Die Lautstärke eines Tons ist die Amplitude des Signals \cite{soundIntensety}.
Wenn man die Lautstärke eines Tons verändern möchte, 
muss das Signals mit einem Faktor multipliziert werden.
Die Multiplikation eines Tons ist in der Soundklasse als Funktion
\lstinline{amplipfy(float factor)} implementiert, welche ebenfalls einfach
die multiply-Funktion der Signalklasse aufruft.

\begin{figure}[h]
    \centering

    \begin{tikzpicture}

        % Sine
        \begin{axis}[
            width=7cm,
            height=4.5cm,
            title={2Hz(blau) und 3Hz(rot)},
            xlabel={Zeit},
            ylabel={Wert},
            xmin=0, xmax=1,
            ymin=-1.2, ymax=1.2,
            xtick={0,1},
            ytick={-1,0,1},
            grid=major,
        ]
            \addplot[
                color=blue,
                line width=1.5pt,
                domain=0:1,
                samples=200
            ] {sin(deg(x)*2*2*pi)};
            \addplot[
                color=red,
                line width=1.5pt,
                domain=0:1,
                samples=200
            ] {sin(deg(x)*3*2*pi)};
        \end{axis}

        % Square
        \begin{axis}[
            width=7cm,
            height=4.5cm,
            title={2Hz+3Hz},
            xlabel={Zeit},
            ylabel={Wert},
            xmin=0, xmax=1,
            ymin=-1.2, ymax=1.2,
            xtick={0,1},
            ytick={-1,0,1},
            grid=major,
            at={(7.5cm,0cm)},
        ]
            \addplot[
                color=red,
                line width=1.5pt,
                domain=0:1,
                samples=200
            ] {sin(deg(x)*2*2*pi)+sin(deg(x)*3*2*pi)};
        \end{axis}

        % Triangle
        \begin{axis}[
            width=7cm,
            height=4.5cm,
            title={(2Hz*0.5+3Hz*0.5)},
            xlabel={Zeit},
            ylabel={Wert},
            xmin=0, xmax=1,
            ymin=-1.2, ymax=1.2,
            xtick={0,1},
            ytick={-1,0,1},
            grid=major,
            at={(0cm,-5.5cm)},
        ]
            \addplot[
                color=red,
                line width=1.5pt,
                domain=0:1,
                samples=200
            ] {(sin(deg(x)*2*2*pi)+sin(deg(x)*3*2*pi))*0.5};
        \end{axis}

        % Sawtooth
        \begin{axis}[
            width=7cm,
            height=4.5cm,
            title={2Hz+3Hz(mit Overflow)},
            xlabel={Zeit},
            ylabel={Wert},
            xmin=0, xmax=1,
            ymin=-1.2, ymax=1.2,
            xtick={0,1},
            ytick={-1,0,1},
            grid=major,
            at={(7.5cm,-5.5cm)},
        ]
            \addplot[
                color=red,
                line width=1.5pt,
                domain=0:1,
                samples=200
            ] {{mod(mod((sin(deg(x)*2*2*pi)+sin(deg(x)*3*2*pi)) + 1, 2) + 2, 2) - 1}};
        \end{axis}

    \end{tikzpicture}

    \caption{Addieren von zwei Sinuswellen.}
    \label{fig:addition_and_multiplication}

\end{figure}

In den Abbildungen \ref{fig:addition_and_multiplication} sieht man die 
Addition von 2 Sinuswellen und die Addition von 2 gestauchten Sinuswellen.
Eine wichtige Beobachtung ist, dass die Addition der nicht gestauchten Wellen
zu einer Amplitude von 2 führt, während die Addition der gestauchten Wellen
unter 1 bleibt. Das ist wichtig, da die Amplitude nicht größer als die Auflösung
sein darf, da sonst ein Überlauf entsteht und der Ton verzerrt wird.

Es wird also empfohlen mit gestauchten Tönen zu arbeiten.

\subsection{Ausgabefunktionen und applyFunktion}

Auch die Ausfangsfunktionen und applyFunktion der Signalklasse werden in der Soundklasse
implementiert. Diese sind wichtig, da sie es ermöglichen die Werte eines Tons 
an externe Systeme wie zum Beispiel einen DAC zu übergeben.

\subsection{Bewertung der Auflösung und Abtastrate}
\label{chap:Bewertung_der_Auflösung_und_Abtastrate}

Nun wurden einige Methoden implementiert anhand deren verschiedene 
Abtastraten und Auflösungen getestet werden können. Dazu werden die 
Abtastrate und die Auflösung gesetzt und anschließend wird die Zeit gemessen
wie lange es dauert eine dieser Methoden $s$ mal auszuführen. Diese Zeit wird in
Prozent einer Sekunde angegeben. Das ist die Zeit, die eine Methode maximal
brauchen darf, um die Abtastrate einzuhalten. Natürlich sollte eine Methode viel 
weniger brauchen, um auch noch Zeit für andere Operationen zu haben.

\begin{table}[h]
    \centering
    \begin{tabular}{|c|c|c|c|c|c|}
        \hline
        Abtastrate & Auflösung & fromSaw & fromSine & add & amplify \\
        \hline
        \hline
        44100 & 16Bit & 2,29 \% & 7,20 \% & 1,05 \% & 1,57 \% \\
        32768 & 16Bit & 1,35 \% & 4,75 \% & 0,78 \% & 1,17 \% \\
        22050 & 16Bit & 1,15 \% & 2,45 \% & 0,52 \% & 0,78 \% \\
        16384 & 16Bit & 0,67 \% & 0,47 \% & 0,39 \% & 0,58 \% \\
        11025 & 16Bit & 0,57 \% & 0,41 \% & 0,26 \% & 0,39 \% \\
        \hline
        \hline
        32768 & 16Bit & 1,35 \% & 4,75 \% & 0,78 \% & 1,17 \% \\
        32768 & 32Bit & 1,25 \% & 6,30 \% & 0,82 \% & 1,19 \% \\
        \hline
        \hline
        16384 & 16Bit & 0,67 \% & 0,47 \% & 0,39 \% & 0,58 \% \\
        16384 & 32Bit & 0,62 \% & 2,48 \% & 0,41 \% & 0,59 \% \\
        \hline
    \end{tabular}
    \caption{Ausführungszeiten  in Abhängigkeit der Abtastrate und Auflösung.}
\end{table}

Wie zu erwarten nimmt die benötigte Rechenzeit mit deiner geringeren Abtastrate ab
und es fällt folgendes auf:
\begin{enumerate}
    \item Abtastraten welche Potenzen von 2 sind, sind nicht besser als andere Abtastraten.
    \item Die Generierung des Sinus ist ab einer bestimmten größe des Arraym mit den vordefinierten Werten langsamer.
    \item Es macht nur bei der Berechnung des Sinus einen Unterschied, ob die Auflösung 16 Bit oder 32 Bit beträgt.
\end{enumerate}

Seien im Folgenden die Abtastrate 32768Hz und die Auflösung 16 Bit.
Vermutung zu 2. Das langsame Laden von Sinuswerten könnte man darauf zurückführen,
wo das Array gespeichert wird. Kleinere Arrays liegen eventuell direkt im RAM und größere
müssen erst geladen werden. Die Ladezeit hängt auch von der Frequenz ab. Das liegt
vermutlich daran, dass mehrere benachbarte Werte gleichzeitig geladen werden.
Die fromSine-Zeiten in der Tabelle oben sind der Durchschnitt über die Frequenzen 1--50.

\begin{table}[h]
    \centering
    \caption{Sinusladezeiten in Abhängigkeit der Frequenz.}
    \label{tab:fromSineFrequenz}
    
    \begin{tabular}{c|cccccccccccc}
        Frequenz [Hz]
        & 1    & 2    & 3    & 4    & 5    & 10   & 20 \\ 
        \hline
        fromSine [\%]
        & 0,92 & 1,06 & 1,20 & 1,45 & 1,94 & 4,00 & 7,00
    \end{tabular}
\end{table}

Die Ladezeiten sind trotzdem viel schneller als die Berechnung des Sinus. 
Diese dauert mit der Sinusfunktion aus \lstinline|math.h|
56,32 \% einer Sekunde im Gegensatz zu 4,75 \%.
