StefansCode/BachelorThesisCS/latex/tex/3_implementation.tex

\section{Implementation}

\subsection{Signal}

\subsubsection{Die Klasse}

Ein digitales Signal wird in seiner simpelsten Form als eine sich ständig
ändernde Variable dargestellt. Der Datentyp der Variable wird dem Nutzer 
überlassen, indem die Signalklasse als Template implementiert wird. 

\begin{lstlisting}[language=C++, 
                       frame=single, 
                       caption={Signalklasse Version 0.1},
                       captionpos=b]
template<typename T>
class Signal {
  T value;
}
\end{lstlisting}

Da viele Funktionen, vor allem 
Filter, auf vorherige Werte zu greifen, lohnt es sich diese auch zu speichen.
Dafür bietet sich ein RingBuffer an. Ein RingBuffer ist ein fest definierter
Speicherblock (zum Beispiel ein Array) mit fester Größe, das ist vorallen 
auf Mikrocontrollern sehr 
wichtig, da hier der Speicher sehr begrenzt ist und Speicherallokation während 
der Laufzeit schnell zu Abstürzen führen kann. Ein Ringbuffer hat auserdem 
einen Index Wert welcher anzeigt, wo in diesen Speicherblock geschrieben 
werden soll. Der Index wird bei jedem schreiben erhöht und fängt wieder am Anfang
des Speicherblocks anzuschreiben, wenn das Ende erreicht ist.
Die Größe des Speichers soll auch den Nutzer überlassen werden. Sie muss aber zur
Compilezeit festgelegt sein.

\begin{lstlisting}[language=C++, 
                       frame=single, 
                       caption={Signalklasse Version 0.2},
                       captionpos=b]
template <typename T, unsigned int BUFFER_SIZE = 256>
class Signal {
private:
  T buffer[BUFFER_SIZE] = {0};
  unsigned int index = 0;
}
\end{lstlisting}

Wenn das Signal zu einem neuen Wert übergeht, muss der Index erhöht werden.
Das passiert in einer Inputfunktion, welche mit dem Prefix \glqq from-\grqq\ 
gekennzeichnet sind. Eine Inputfunktion gibt immer eine Referenz auf das 
Signalobjekt zurück.

\begin{lstlisting}[language=C++, 
                       frame=single, 
                       caption={Signalklasse Version 0.3},
                       captionpos=b]
template <typename T, unsigned int BUFFER_SIZE = 256>
class Signal {
private:
  T buffer[BUFFER_SIZE] = {0};
  unsigned int index = 0;
public:
  Signal& fromValue(T value) {
    index = (index + 1) % BUFFER_SIZE;
    buffer[index] = value;
    return *this;
  }
}
\end{lstlisting}

Eine Funktion, die welche mit dem Prefix \glqq return-\grqq\ 
gekennzeichnet sind, ist eine Ausgangsfunktion. 
Solche Funktionen geben keine Signalreferenz zurück, sondern zum Beispiel den 
momentanen Wert.

\begin{lstlisting}[language=C++, 
                       frame=single, 
                       caption={Signalklasse Version 0.3},
                       captionpos=b]
template <typename T, unsigned int BUFFER_SIZE = 256>
class Signal {
private:
  T buffer[BUFFER_SIZE] = {0};
  unsigned int index = 0;
public:
  ...

  T returnValue() {
    return buffer[index];
  }
}
\end{lstlisting}

Alle anderen Funktionen sind Funktionen, welche eine Signalreferenz zurückgeben
und im gegansatz zu Inputfunktionen nicht den Index erhöhen. Das sind zum Beispiel
add, multiply oder applyFunction. Letzteres erlaubt es dem Nutzer selbstdefinierte 
in die Verarbeitungskette einzufügen.

\begin{lstlisting}[language=C++, 
                       frame=single, 
                       caption={Signalklasse Version 0.4},
                       captionpos=b]
template <typename T, unsigned int BUFFER_SIZE = 256>
class Signal {
private:
  T buffer[BUFFER_SIZE] = {0};
  unsigned int index = 0;
public:
  ...

  Signal& add(Signal &other) {
    this->buffer[index] += other.buffer[other.index];
    return *this;
  }

  Signal& multiply(T value) {
    this->buffer[index] = T(this->buffer[index] * value);
    return *this;
  }

  SIgnal applyFunction(T (*func)(T data, void *param), 
                       void *param) {

    buffer[index] = func(buffer[index], param);
    return *this;
  }
}
\end{lstlisting}

% mehr funktionen einbauen

\subsubsection{Anwendung}
% wohin soll das Example?
Im Anhang sieht man eine Beispielanwendung in der ArduinoIDE. Hier werden ein
Lichtabhängiger Widersand, und ein Potenztiometer eingelesen. Der Potentiometerwert
wird dazu verwendet, um den aktuell stabielen Lichtwert zu kompensieren. Dann wird
eine LED angeschaltet, wenn der compensierte lichtwert unter 0 sinkt. Hält man den 
Lichtabhängigen Wiederstand gegen eine Lichtquelle oder einen reflektierenden 
hintergrund kann durch Blocken des Lichts eine Bewegung erkannt werden. 
(Es gibt bessere Möglichkeiten dies umzusetzen aber zu Demonstrationszwecken 
sollte dieses Beispiel reichen).

Der Code verkürzt sich hier nicht wirklich. Im Gegenteil er wird wegen der 
zusätzlich definierten Funktionen erstmal komplexer. Sollen nun weitere 
Funkionen wie zum Beispiel Filter in die Verarbeitungskette eingebracht werden, 
kann dies mit der Signalbibliothek einfacher und schöner umgesetzt werden.

Ein Besseres und ausfürlicheres Beispiel liefert die Erweiterung von Signal zu 
Sound im nächsten Unterkapitel und die Anwendung der Soundklasse als Synthesizer
im nächsetn Kapitel.

\subsubsection{Anmerkungen}
Ein großer Unterschied zwischen der Signalklasse und Java-streams ist, dass 
die Inputfunktionen der Signalklasse keine statischen Memberfunktionen sind.
Das liegt daran, dass ein Signal im Normalfall in einer Endlosschleife 
aktualisiert wird und nicht wie ein Stream einmal erschaffen und direkt 
beendet wird. 

Ein weiterer wichtiger Punkt ist, dass der Index in den Inputfunktionen erhöht
werden muss, da diese der auch einen neuen Wert setzt und für andere Funktionen 
nicht garantiert ist, dass diese aufgerufen werden.

Außerdem ist es wichtig, dass nur Referenzen des Signals zurück- und übergeben werden. 
Auch wenn das Signal nicht verändert wird ist dies wichtig, da so zeitintensieves
Kopieren des Buffers verhindert wird.

\subsection{Sound}

Die Soundklasse ist eine Erweiterung bzw. eine Anwendung der Signalklasse. 
Diese Erweiterung wird umgesetzt, indem die Soundklasse ein Signal als 
Membervariable besitzt.

 I2S funktioniert mit 
Pulse-Code-Modulation (PCM) Daten. Das ist ein unkomprimiertes Audio format mit
meistens 16,24 oder 32 Bit unsigned Integern.  In dem config Header ist ein 
Datentyp mit dem Namen sample definiert, welcher genau so ein unsigned Int ist.
Hier kann man die Auflösung global einstellen.
% todo finde Quellen zu PCM.
