StefansCode/BachelorThesisCS/latex/KI_NOTES.txt

KI genutzt für:
    quellen angaben ausfüllen
    umstrukturierung des TExtes und Wortwahl
    Grafiken
