StefansCode/BachelorThesisCS/latex/tex/5_conclusion.tex

\section{Fazit}

\subsection{Bewertung der Signal- und Soundklasse}

Die Signal- und Soundklasse wurden erfolgreich implementiert. Die Rückgabe von 
einer Referenz auf das Objekt selbst ermöglicht es, mehrere Operationen mit 
Methodchaining 
hintereinander auszuführen. Durch die strikte Trennung der Hardware und 
der Signal- und Soundklasse ist es möglich, die Klassen auf anderen 
Plattformen zu nutzen und zu testen. Außerdem ist es durch die einfache Struktur
 leicht möglich
weitere Fuktionen in die Signal- und Soundklasse zu implementieren.

\subsection{Bewertung des Synthesizers}

Es wurde ein musikalisch nutzbarer Synthesizer
gebaut. Durch die Fähigkeit mehrere 
Töne gleichzeitig zu spielen, eignet sich dieser Synthesizer gut um Akkordfolgen
zu spielen. Auch Melodien sind mit dem Synthesizer gut zu spielen.
Wegen der Hüllkurve und der Auswahl an verschiedenen Wellenformen
lassen sich auch verschiedene Klänge erzeugen. Die Vielfalt an Klängen 
lässt sich durch Erweiten der Soundklassen und durch weitere Parameter
in dem Synthesizer erhöhen.
