StefansCode/BachelorThesisCS/latex/fig/UML_diagram.pdf

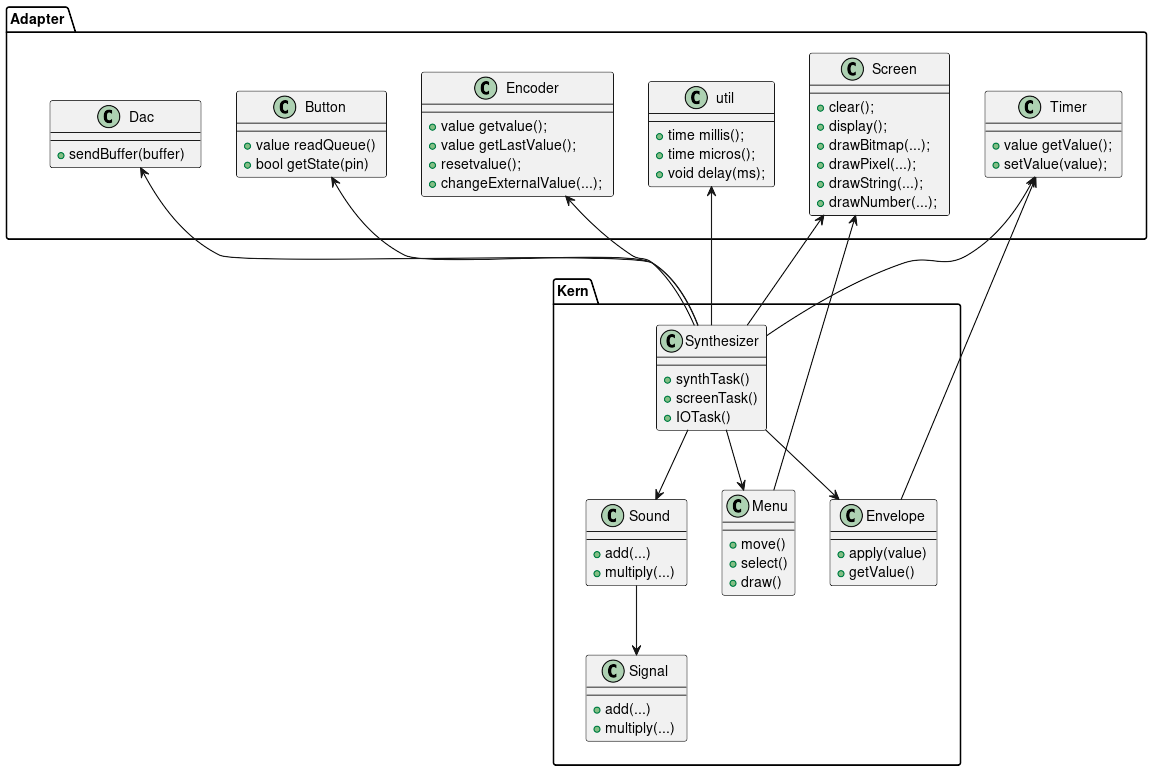
[picture p27: page 1]
