StefansCode/BachelorThesisCS/latex/fig/UML_diagram.png

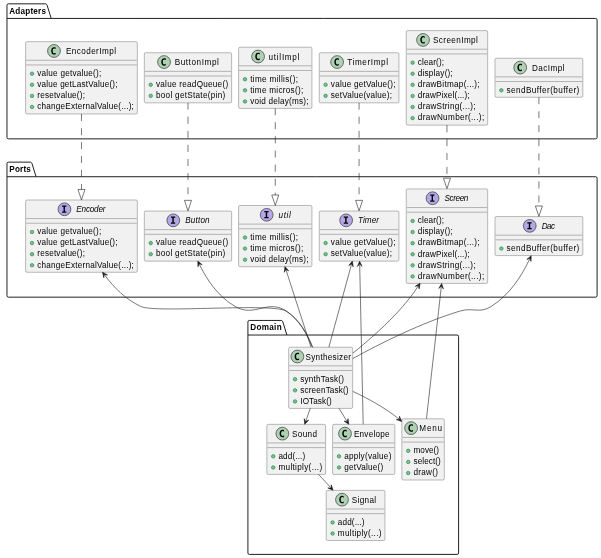
latex/fig/UML_diagram.png
