StefansCode/BachelorThesisCS/hardware/Hülle.step

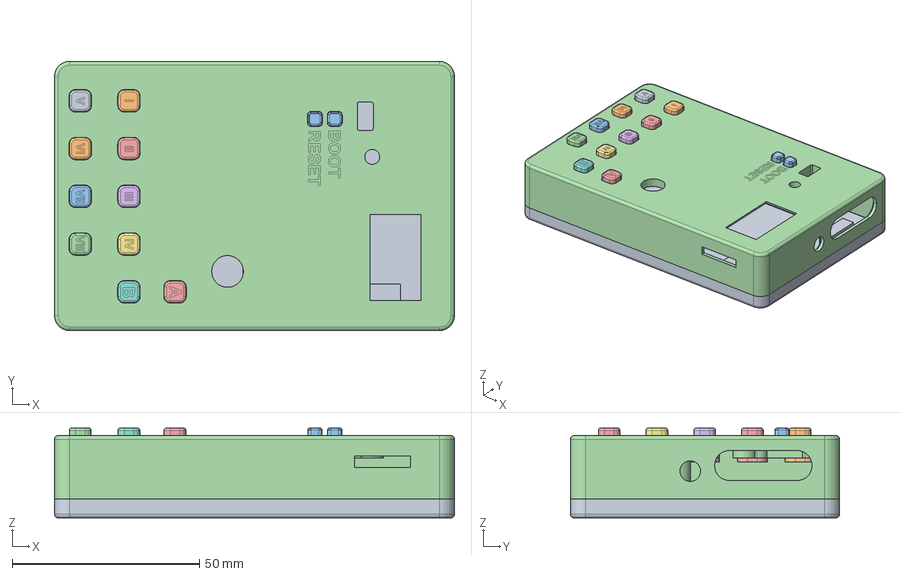
[picture p29: CAD file, 2026-08-29]
hardware/Hülle.step
106.8 x 71.9 x 24.0 mm
