StefansCode/BachelorThesisCS/(list of files, cad)

Other CAD files:
hardware/Hülle.stl
