StefansCode/BachelorThesisCS/code/thesisCode/main/main.cpp

// #include "sdkconfig.h"
#include "adapter/button/button.h"
#include "adapter/dac/i2sDac.h"
#include "adapter/Encoder/Encoder.h"
#include "adapter/rgbLed/rgbLed.h"
#include "adapter/screen/screen.h"


#include "sound/config.h"

#include "core/synthesizer/synthesizer.h"

#include "../test/onHardwareTest/core/sound/soundInputTest.h"
#include "../test/onHardwareTest/core/sound/miniSynth.h"
// #include "../test/onHardwareTest/core/sound/soundOutputTest.h"
// #include "../test/onHardwareTest/core/envelope/envelopetestWithPrints.h"
// #include "../test/onHardwareTest/adapter/screenFortTest.h"

extern "C" void app_main(void) {

  buttons.init();
  dac.init(STANDART_SAMPLE_RATE, BITS_PER_SAMPLE);
  encoder.init();
  rgbLed.init();
  screen.init();

  // runSoundInputTest_allWaveforms();
  // runSoundInputTest_switchWaveforms();
  // runSoundInputTest_overflow();
  // runSoundInputTest_waveformCalulationSpeed();
  runSoundInputTest_calulationSpeeds();

  // runSoundOutputTest();
  // runSoundOutputTest_unsigned();

  // runEnvelopeTestWithPrints();

  // runScreenFontTest();

  // runMiniSynthTest();

  synth.run();

  while(1){
    vTaskDelay(1000/portTICK_PERIOD_MS);
  }
}
