StefansCode/BachelorThesisCS/code/thesisCode/main/core/synthesizer/notes/notes.cpp

#include "notes.h"

uint8_t lydian[8] =     {0, 2, 4, 6, 7, 9, 11, 12};
uint8_t ionian[8] =     {0, 2, 4, 5, 7, 9, 11, 12};    // major scale or Dur
uint8_t mixolydian[8] = {0, 2, 4, 5, 7, 9, 10, 12};
uint8_t dorian[8] =     {0, 2, 3, 5, 7, 9, 10, 12}; 
uint8_t aolian[8] =     {0, 2, 3, 5, 7, 8, 10, 12};    // minor scale or Moll
uint8_t phrygian[8] =   {0, 1, 3, 5, 7, 8, 10, 12};
uint8_t locrian[8] =    {0, 1, 3, 5, 6, 8, 10, 12};  

uint8_t doubleHarmonic[8] = {0, 1, 4, 5, 7, 8, 11, 12};

const uint8_t NUMBER_OF_SCALES = 8;
uint8_t *scales[8] = {
lydian,
ionian,
mixolydian,
dorian,
aolian,
phrygian,
locrian,
doubleHarmonic
};

const char *scaleNames[8] = {
"LYDIAN",   // lydian
"IONIAN",   // major scale
"MXOLYN",   // mixolydian
"DORIAN",   // dorian
"AOLIAN",   // minor scale
"PHRYG",    // phrygian
"LOCR",     // locrian
"2HARMO"    // double harmonic
};

const char * noteNames[12] = {
"A",
"A#",
"B",
"C",
"C#",
"D",
"D#",
"E",
"F",
"F#",
"G",
"G#"
};

const char * waveformNames[5] = {
"SAW",      // sawtooth
"SQUARE",   // square
"TRINGL",   // triangle
"SINE",      // sine
"NOISE"     // noise
};

const char * sampleRateNames[3] = {
"11025",
"22050",
"44100"
};

const uint16_t NOTES[] = {
16,     // 1    C0
17,     // 2    C#0
18,     // 3    D0
19,     // 4    D#0
20,     // 5    E0
21,     // 6    F0
23,     // 7    F#0
24,     // 8    G0
25,     // 9    G#0
27,     // 10   A0
29,     // 11   A#0
30,     // 12   B0
32,     // 13   C1
34,     // 14   C#1
36,     // 15   D1
38,     // 16   D#1
41,     // 17   E1
43,     // 18   F1
46,     // 19   F#1
49,     // 20   G1
51,     // 21   G#1
55,     // 22   A1
58,     // 23   A#1
61,     // 24   B1
65,     // 25   C2
69,     // 26   C#2
73,     // 27   D2
77,     // 28   D#2
82,     // 29   E2
87,     // 30   F2
92,     // 31   F#2
98,     // 32   G2
103,    // 33   G#2
110,    // 34   A2
116,    // 35   A#2
123,    // 36   B2
130,    // 37   C3
138,    // 38   C#3
146,    // 39   D3
155,    // 40   D#3
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
};
