StefansCode/BachelorThesisCS/(commit log)

2026-06-20 add library for the rgb-led
2026-07-16 rename encoder
2026-07-16 add threadSaveVariables
2026-07-26 print values in menu
2026-08-07 add fast threadsave access to envelope
2026-08-10 add example Arduinocode
2026-08-11 allow samplerates of power 2
2026-08-12 übergebe dem dac die auflösung
2026-08-19 use sample as lookuptable type
2026-08-19 add threadsave float
2026-08-23 move threadsaveVariable to core
2026-08-26 rename encoder functions
2026-08-29 add hardware files
    [Hülle.step, Hülle.stl]
2026-09-08 fix 32Bit Sample error
    [main.cpp]
